Davideando/lookat-1/LOOKAT_Presentacio.pptx.pdf

# Master on Robotics

# Postgraduate in Industrial Robotics

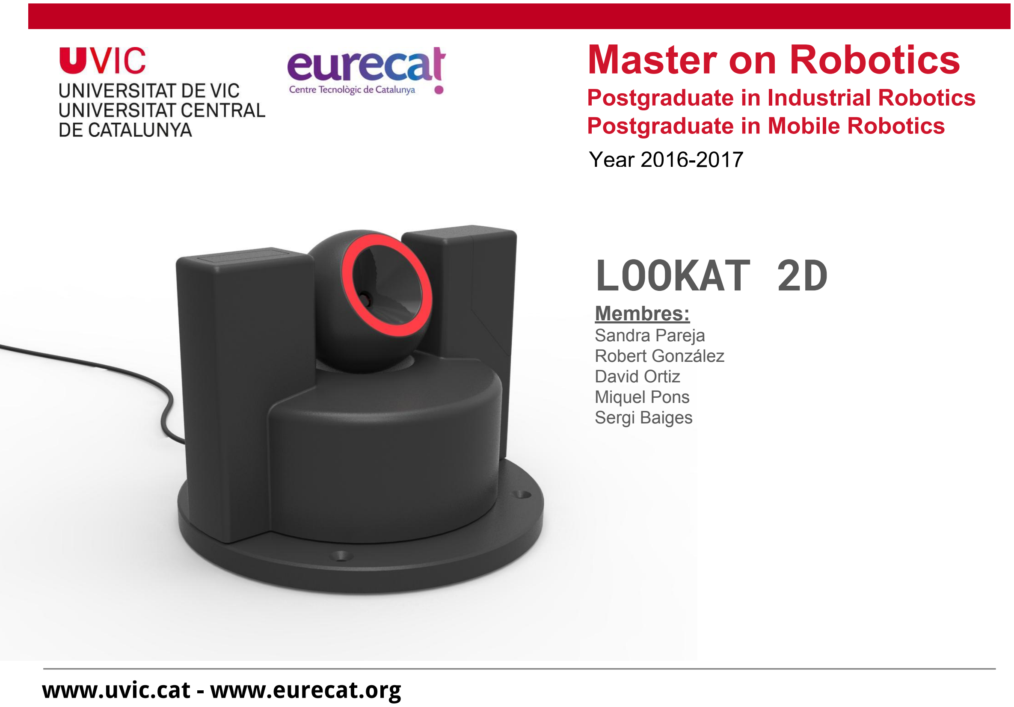
[picture p1: page 1]

Arnau Ramisa Ayats [iri.upc.edu/people/aramisa]

### 3. Pattern Recognition

# www.uvic.cat - www.eurecat.org

# Postgraduate in Mobile Robotics

# Year 2016-2017

# LOOKAT 2D

## Membres:

## Sandra Pareja Robert González David Ortiz Miquel Pons Sergi Baiges

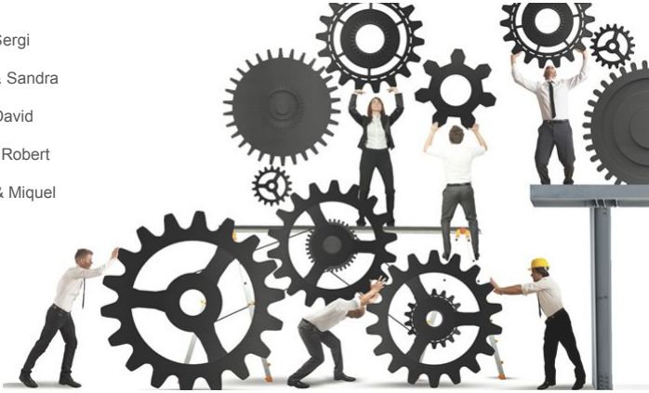
[picture p2: figure]

### Master on Robotics

Postgraduate in Industrial Robotics / Mobile Robotics

# Equips de treball

## Disseny: Miquel & Sergi

## Cinemàtica: Sergi & Sandra

## Control: Sandra & David

## Percepció: David & Robert

## Integració: Robert & Miquel

# Block diagram

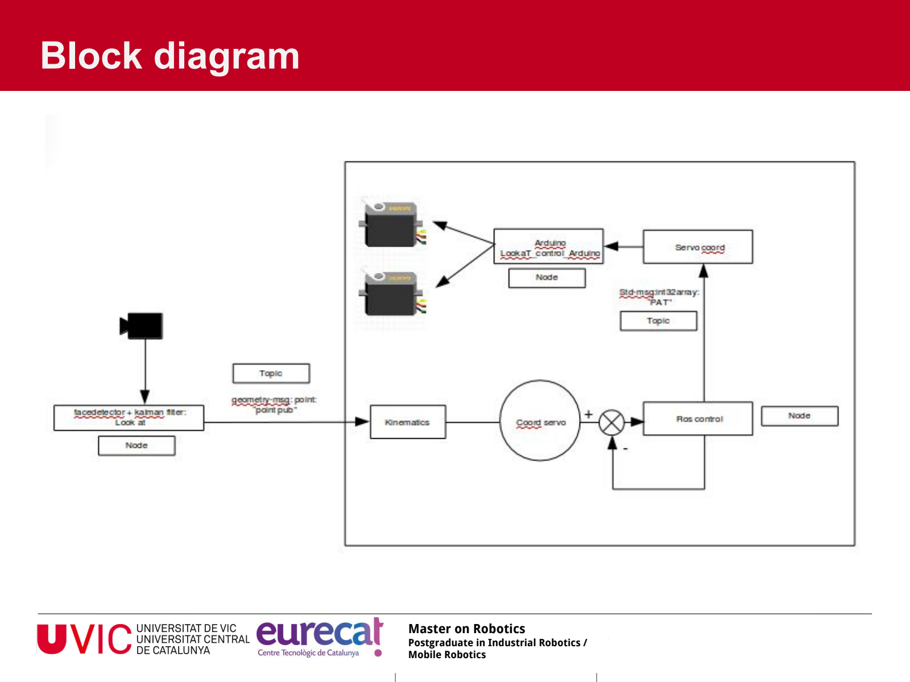
[picture p3: page 3]

# Premises:

# - 2 eixos de moviment:

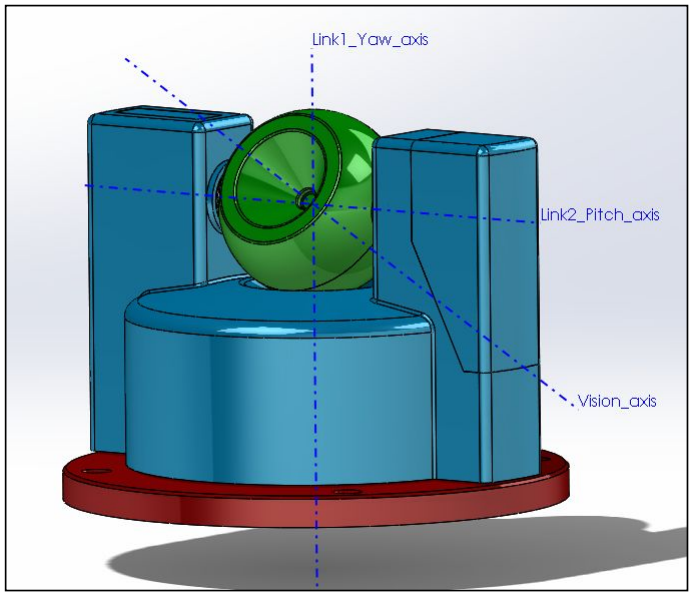
[picture p4: figure]

# - Pitch i Yaw

# - 2 servos de ± 90º - Futaba S3003

- MG995

# - Coincidència d’eixos en un punt:

# Disseny

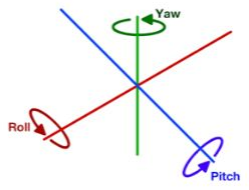
[picture p5: figure]

# - Origin Master - Link 2 Origin:

# Disseny

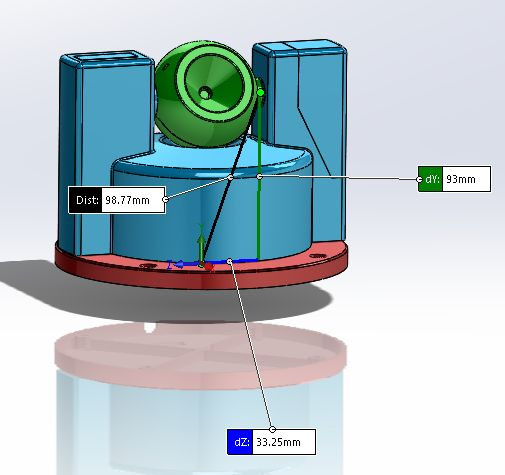
[picture p6: figure]

# - Origin Master - Webcam Axis Origin:

# Disseny

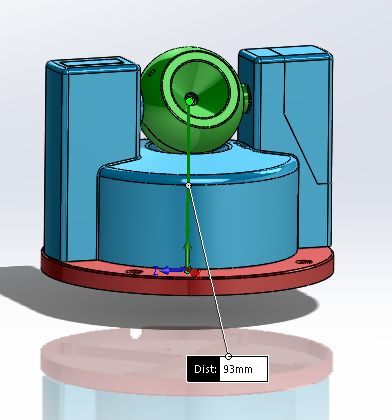
[picture p7: figure]

# Disseny

# Explosionat

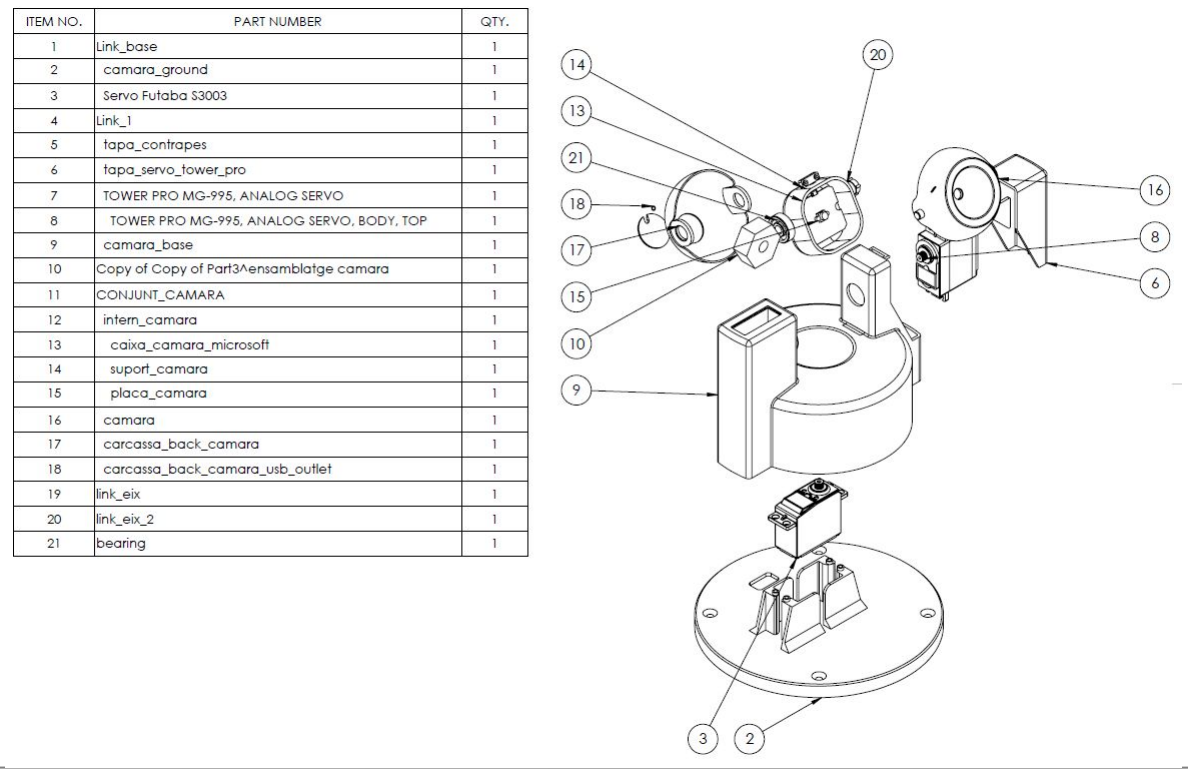
[picture p8: figure]

# Disseny

# Dimensions generals

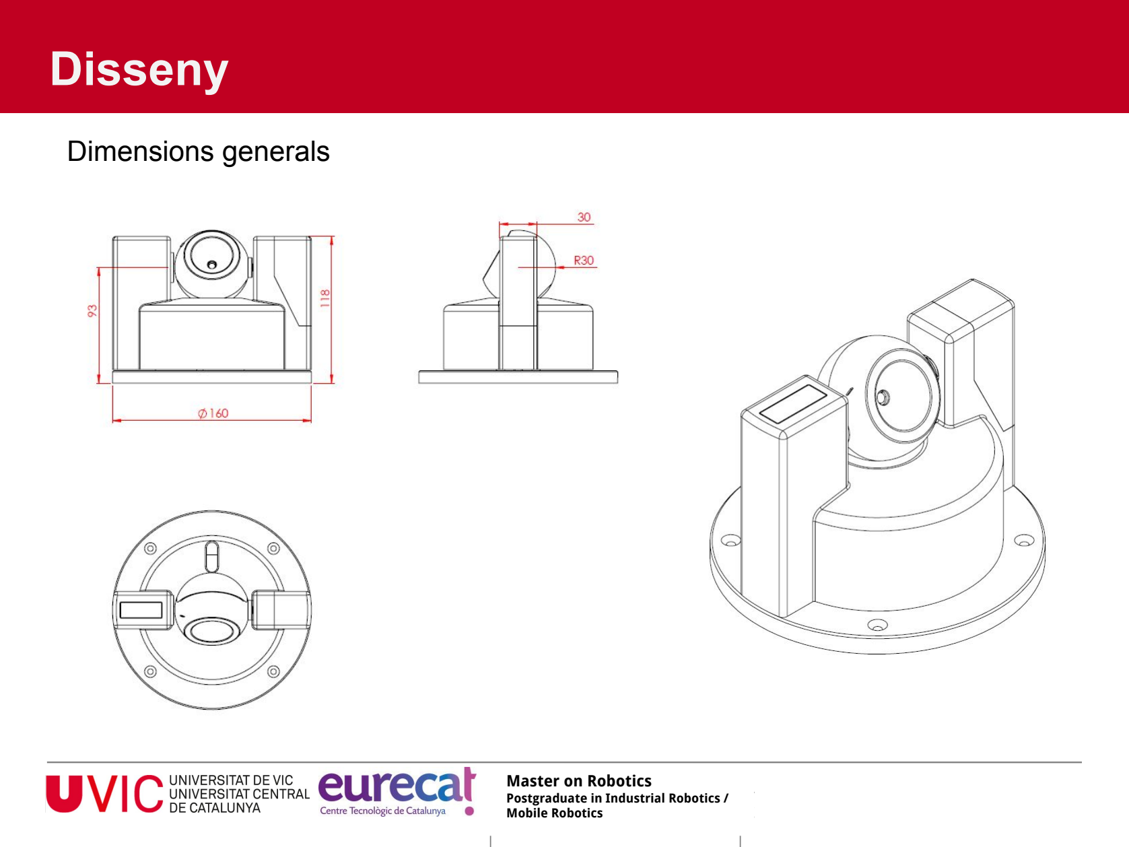
[picture p9: page 8]

# Disseny

# Secció A-A

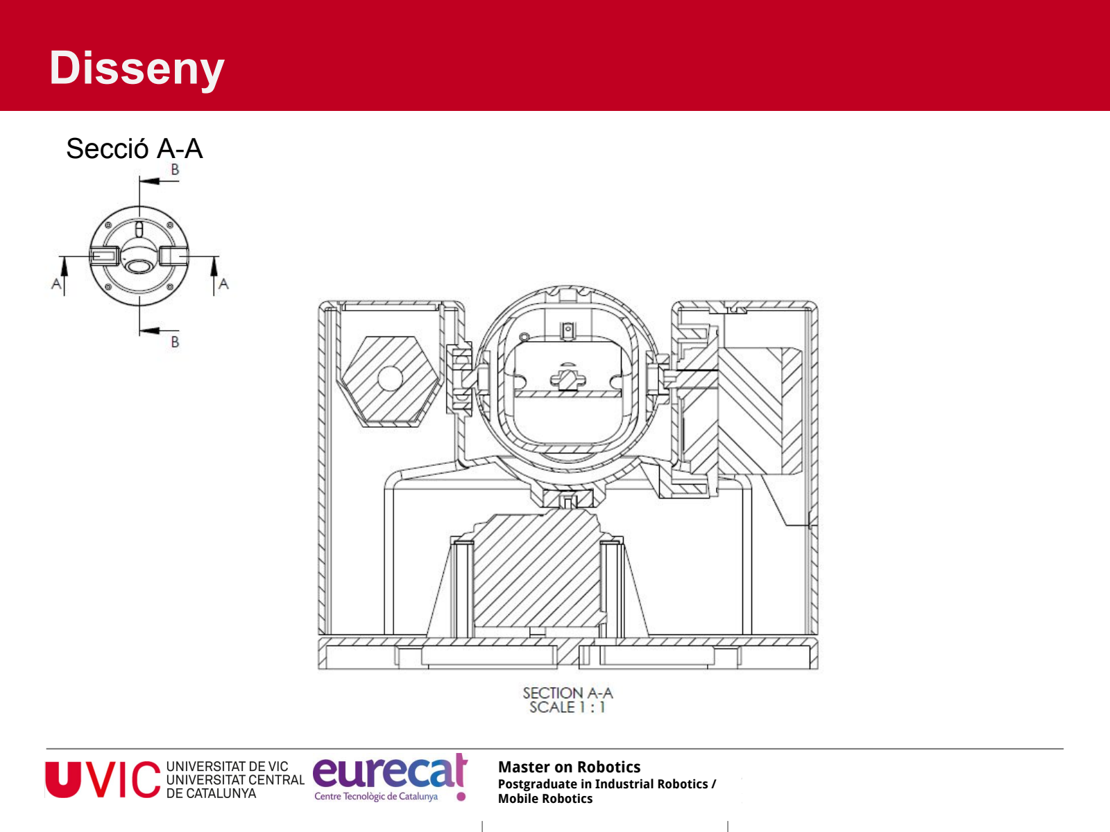
[picture p10: page 9]

# Disseny

# Secció B-B

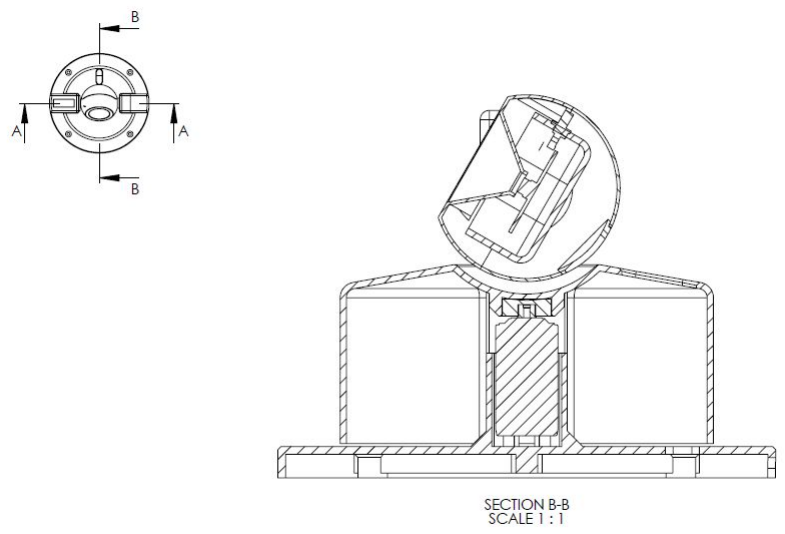
[picture p11: figure]

# Blocs percepció

# Percepció

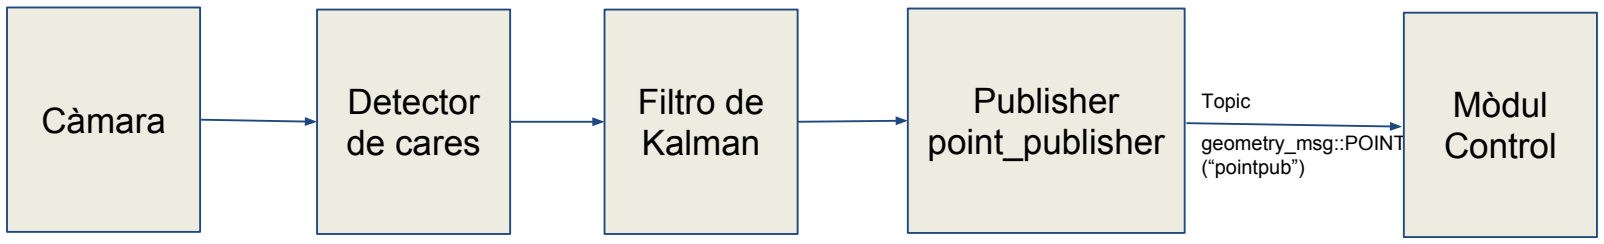
[picture p12: figure]
Càmara; Publisher; point_publisher; Topic; geometry_msg::POINT (“pointpub”); Mòdul Control; Detector de cares; Filtro de Kalman
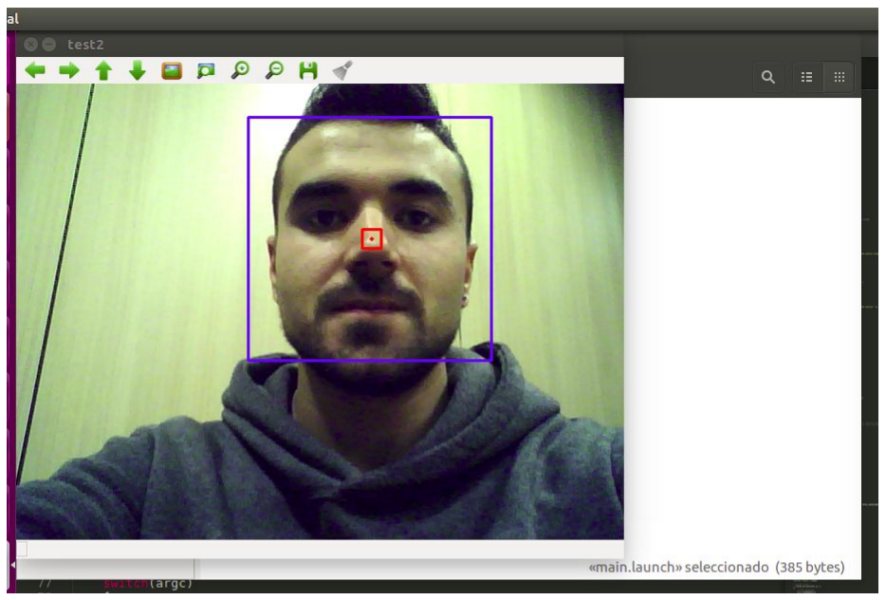
[picture p13: figure]

# Cinemàtica

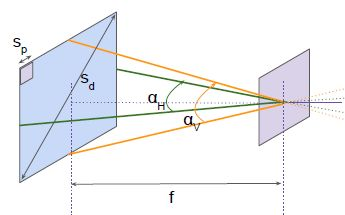
[picture p14: figure]

## Posició inicial dels motors:

yaw = 90;

pitch = 65;

## Limits:

## Pan 0º - 180º ---> Range final = 180º

## Tilt 30º - 100º ---> Range final = 70º

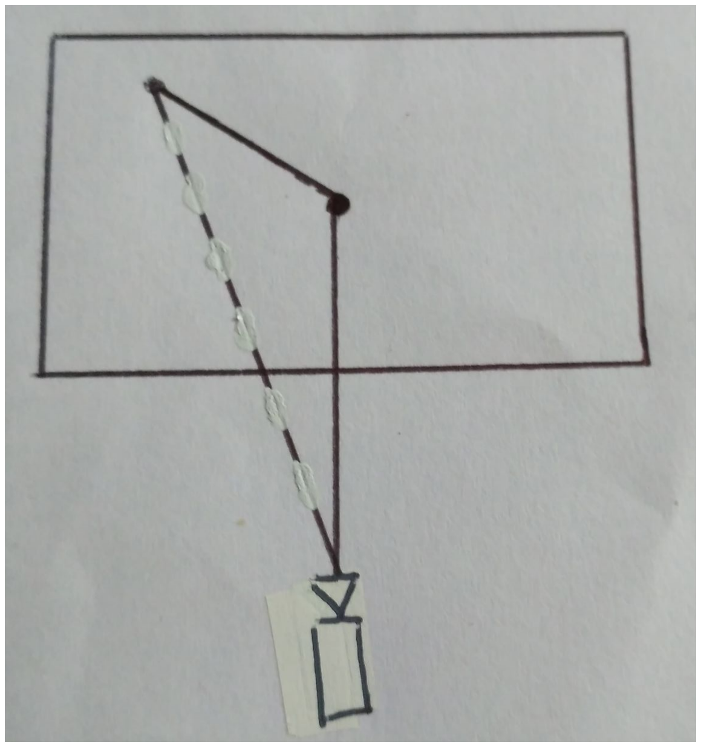
[picture p15: figure]

## Conversión de píxels a graus:

DEGREE_ADJUST_X = 0.14; | --- > 90º / 640pixels
DEGREE_ADJUST_Y = 0.1875; | --- > 90º / 480pixels

## Resolució de la càmara

WIDTH = 640;

HEIGHT = 480;

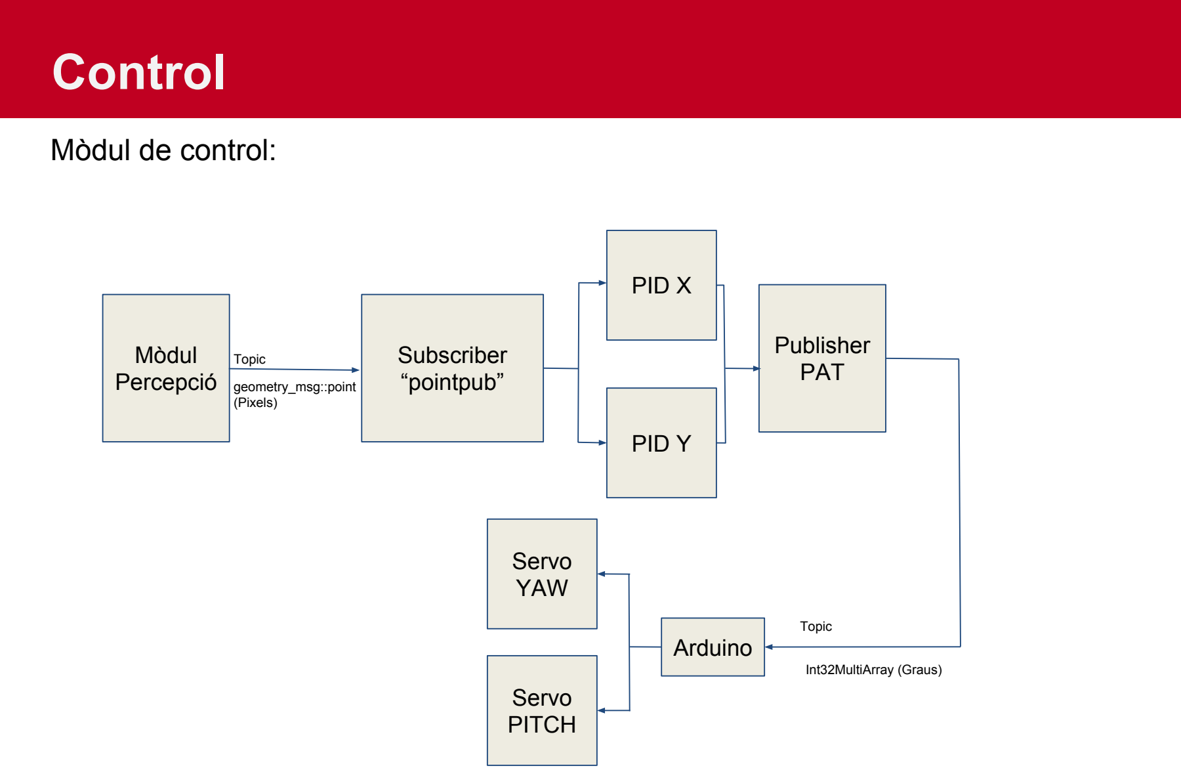
[picture p16: figure]
Mòdul de control:; Control; Mòdul Percepció; Subscriber “pointpub”; Topic; geometry_msg::point (Pixels); PID Y; PID X; Publisher PAT; Arduino; Servo YAW; Servo PITCH; Int32MultiArray (Graus)

# Ros Tree

# Llicencia: GNU

# GitHub: https://github.com/Sandraa03/lookat

# Lookat description

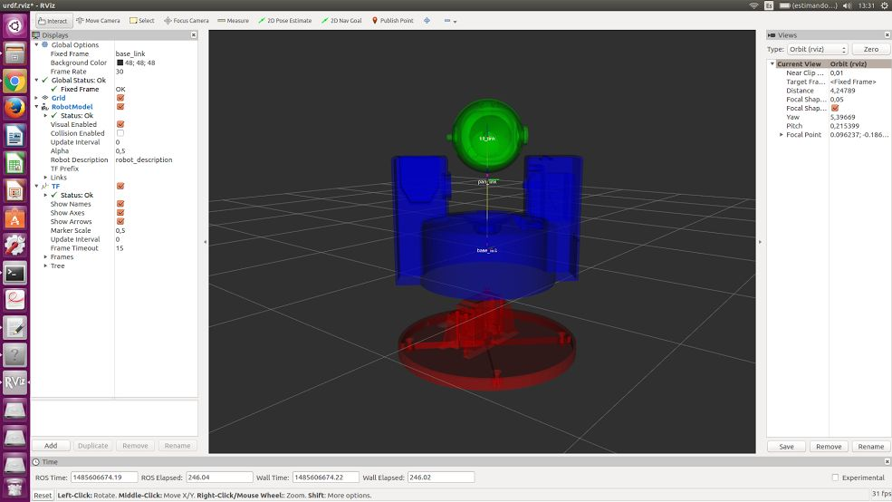
[picture p17: figure]
