Davideando/lookat-1/lookat/lookat_description/urdf/meshes/pan_link.stl

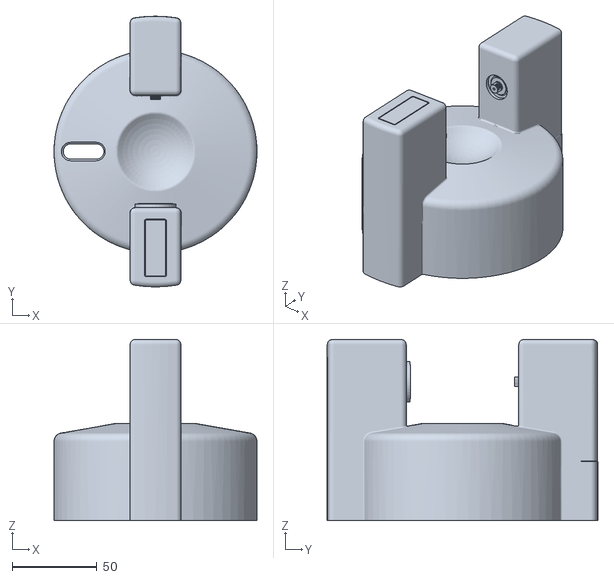
[picture p18: CAD file, 2017-02-09]
lookat/lookat_description/urdf/meshes/pan_link.stl
120.0 x 160.0 x 107.0
