Davideando/lookat-1/lookat/lookat_description/urdf/meshes/tilt_link.stl

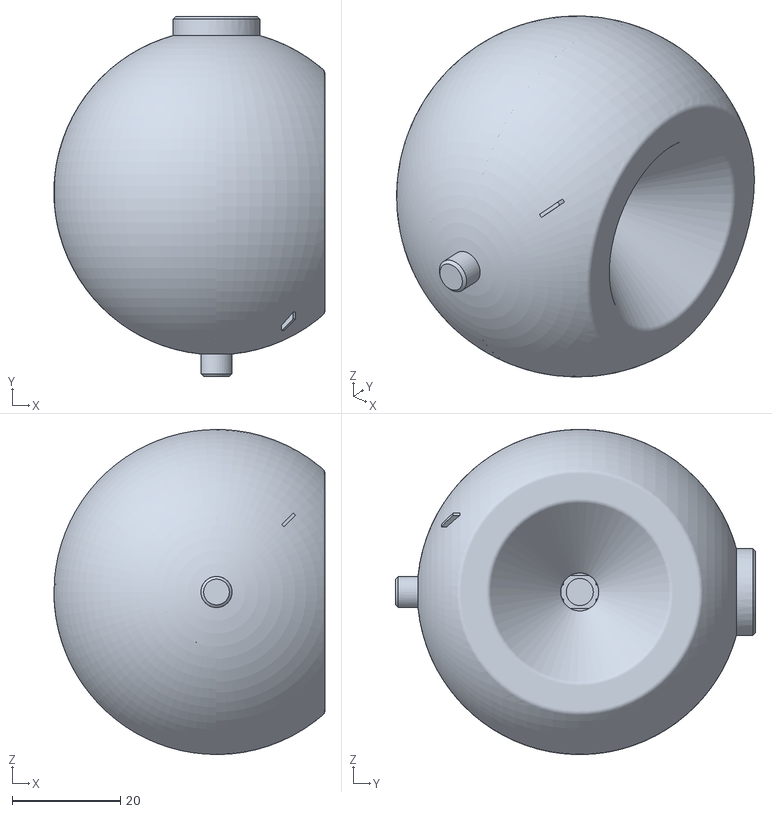
[picture p19: CAD file, 2017-02-09]
lookat/lookat_description/urdf/meshes/tilt_link.stl
50.0 x 66.4 x 60.0
